imix/stez80/stez80/Design-Review-v0-1.ods

Schematic checks | Result | Comment
Global
Pass ERC | OK | 0 Errors, 0 Warnings
Remainng Warnings checked and OK | OK | none
Testing
LEDs on all power lines | OK
Power management
All power lines clearly labeled | OK
Polarity protection if required | OK
Fuse if necessary | none
Schematic – CPU
Title block filled out correctly | OK
All separate blocks have name/border | OK
All properly aligned | OK
Schematic – Support
Title block filled out correctly | OK
All separate blocks have name/border | OK
All properly aligned | OK
U1 – Schmitt Trigger
Label corresponds to component | OK | 74LS14 but should work
All labeled Inputs connect to correct net | OK
All Power pins have a decoupling cap | OK
All Power pins are connected to the correct voltage rail | OK
All unused pins are correctly NC, pull UP or Down | OK
Pin numbers correspond to function in Datasheet | OK
Footprint form factor matches Datasheet | OK
Footprint pinout matches Datasheet | OK
U2 – Z80 CPU
Label corresponds to component | OK
Adress Bus correctly connected | OK
Data Bus correctly connected | OK
All labeled Inputs connect to correct net | OK
All Power pins have a decoupling cap | OK
All Power pins are connected to the correct voltage rail | OK
All unused pins are correctly NC, pull UP or Down | OK
Pin numbers correspond to function in Datasheet | OK
Footprint form factor matches Datasheet | OK
Footprint pinout matches Datasheet | OK
U3 – RAM
Label corresponds to component | OK
Adress Bus correctly connected | OK
Data Bus correctly connected | OK
All labeled Inputs connect to correct net | OK
All Power pins have a decoupling cap | OK
All Power pins are connected to the correct voltage rail
All unused pins are correctly NC, pull UP or Down | OK
Pin numbers correspond to function in Datasheet | OK
Footprint form factor matches Datasheet
Footprint pinout matches Datasheet
U4 – ROM
Label corresponds to component | OK
Adress Bus correctly connected | OK
Data Bus correctly connected | OK
All labeled Inputs connect to correct net | OK
All Power pins have a decoupling cap | OK
All Power pins are connected to the correct voltage rail | OK
All unused pins are correctly NC, pull UP or Down | OK
Pin numbers correspond to function in Datasheet | OK
Footprint form factor matches Datasheet | OK
Footprint pinout matches Datasheet | OK
U5 Atmega
Label corresponds to component | OK
Adress Bus correctly connected | OK
Data Bus correctly connected | OK
All labeled Inputs connect to correct net | OK
All Power pins have a decoupling cap | OK
All Power pins are connected to the correct voltage rail | OK
All unused pins are correctly NC, pull UP or Down | OK
Pin numbers correspond to function in Datasheet | OK
Footprint form factor matches Datasheet | OK
Footprint pinout matches Datasheet | OK
U6 SIO
Label corresponds to component | OK
Adress Bus correctly connected | OK
Data Bus correctly connected | OK
All labeled Inputs connect to correct net | OK
All Power pins have a decoupling cap | OK
All Power pins are connected to the correct voltage rail | OK
All unused pins are correctly NC, pull UP or Down |  | channel B? Leave as is for the moment
Pin numbers correspond to function in Datasheet | OK
Footprint form factor matches Datasheet | OK
Footprint pinout matches Datasheet | Ok
U7 MAX232
Label corresponds to component | OK
All labeled Inputs connect to correct net |  | 1uF Ceramic or Tantalum
All Power pins have a decoupling cap | OK
All Power pins are connected to the correct voltage rail | OK
All unused pins are correctly NC, pull UP or Down | OK
Pin numbers correspond to function in Datasheet | OK
Footprint form factor matches Datasheet | OK
Footprint pinout matches Datasheet | OK
Y1 Crystal
Resistors
Correct values for application | OK
Correct wattage for application | OK
Footprint form factor as required
Diodes
Correct polarity | OK
Correct wattage for application | OK
LEDs
Correct polarity | OK
Resistor properly calculated | OK
Capacitors
Correct polarity if relevant | OK
Correct Voltage Rating | OK
J1 Debug Port
Pin numbers correspond to function in Datasheet | OK
Footprint form factor matches Datasheet | OK
J2 DC Jack
Pin numbers correspond to function in Datasheet | OK
Footprint form factor matches Datasheet | OK
J3 RS232
Pin numbers correspond to function in Datasheet | OK
Footprint form factor matches Datasheet | OK
PCB checks
Run DRC
Footprints well aligned | good enough…
If sockets are planned, enough space | good enough?
PCB markings, date, version, name etc. | OK
stackup corresponds to factory | not relevant
limits correspond to factory | OK
no sensitive tracks under noisy components
U1 decoupling | OK
U2 decoupling | OK
U3 decouping | OK
U4 decoupling | OK
U5 decoupling | not ideal
U6 decoupling | OK
U7 decoupling | OK
Y1 decoupling | OK
