imix/stez80/stez80/exports/stez80.pdf

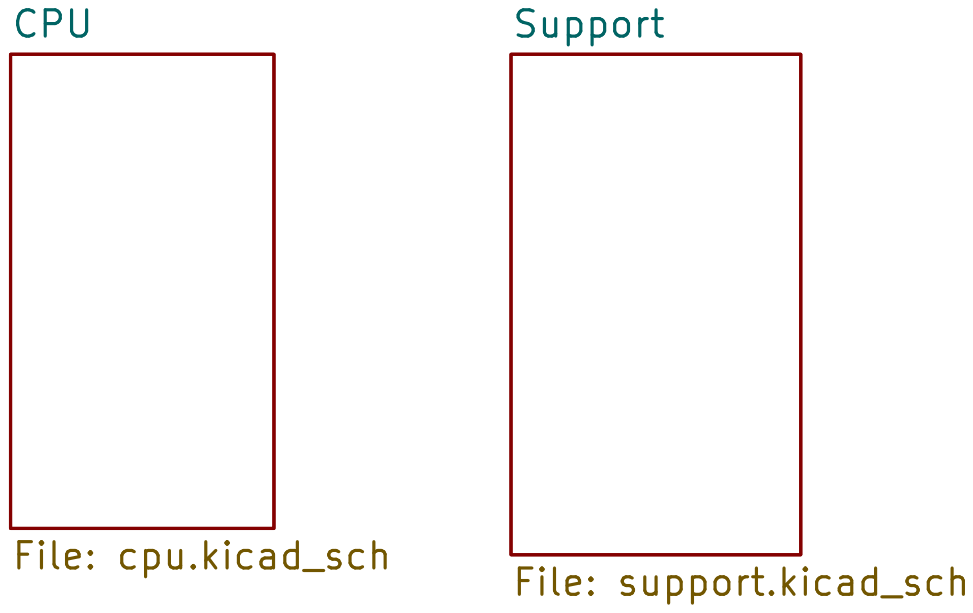
[picture p1: page 1]

Support File: support.kicad_sch CPU

File: stez80.kicad_sch Sheet: /
Id: 1/3 Title: Ste z80 board

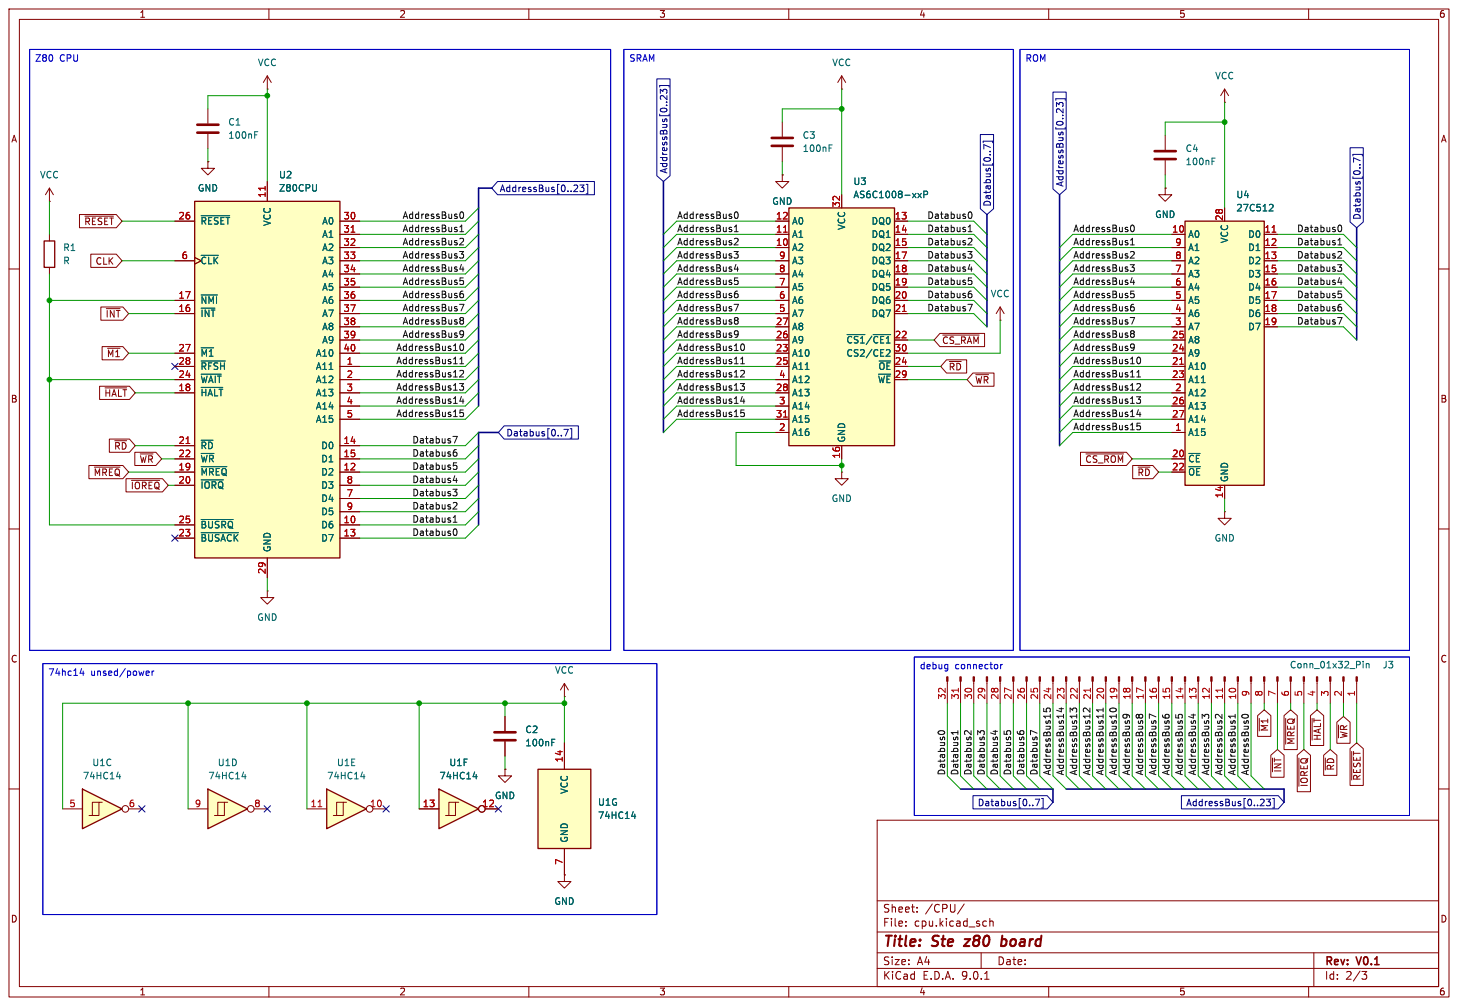
[picture p2: page 2]

File: cpu.kicad_sch Sheet: /CPU/
Id: 2/3 Title: Ste z80 board

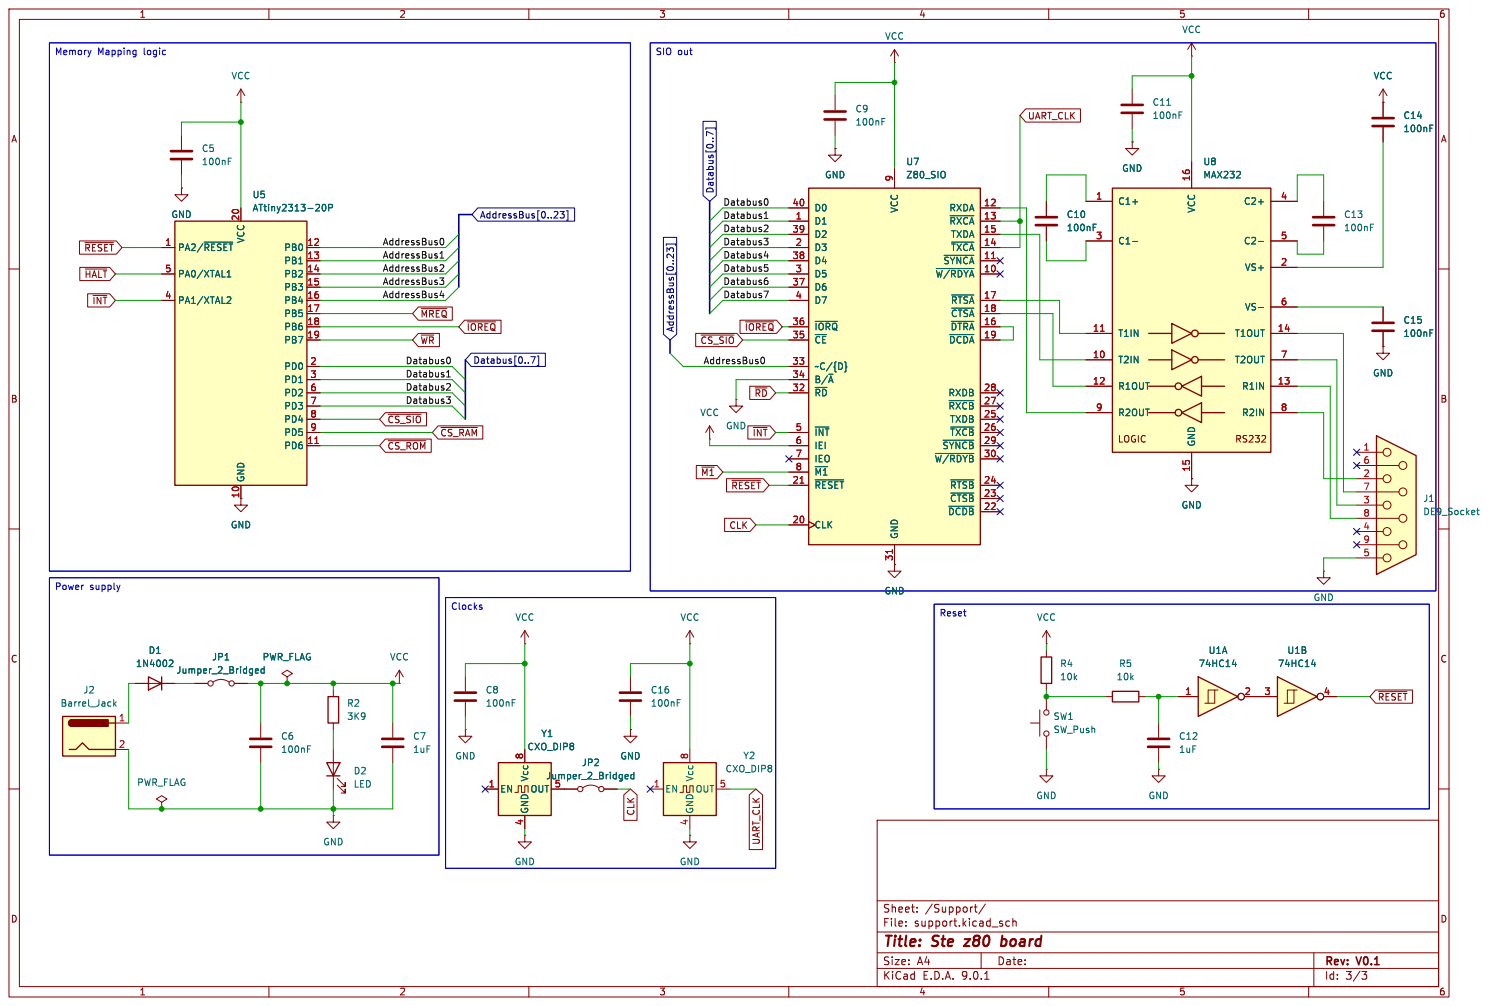
[picture p3: page 3]

9 GND 31 RXDA 12 ~{RXCA}13 TXDA 15 ~{TXCA}14 ~{SYNCA}11 ~{W/RDYA}10 ~{RTSA}17 ~{CTSA}18 ~{DTRA}16 ~{DCDA}19 RXDB 28 ~{RXCB}27 TXDB 25 ~{TXCB}26 ~{SYNCB}29 ~{W/RDYB}30 ~{RTSB}24 ~{CTSB}23 ~{DCDB}22 U7 Z80_SIO

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

File: support.kicad_sch Sheet: /Support/
Id: 3/3 Title: Ste z80 board
