imix/stez80/stez80/stez80.kicad_pcb

## KiCad design stez80/stez80.kicad_pcb (2025-05-18)

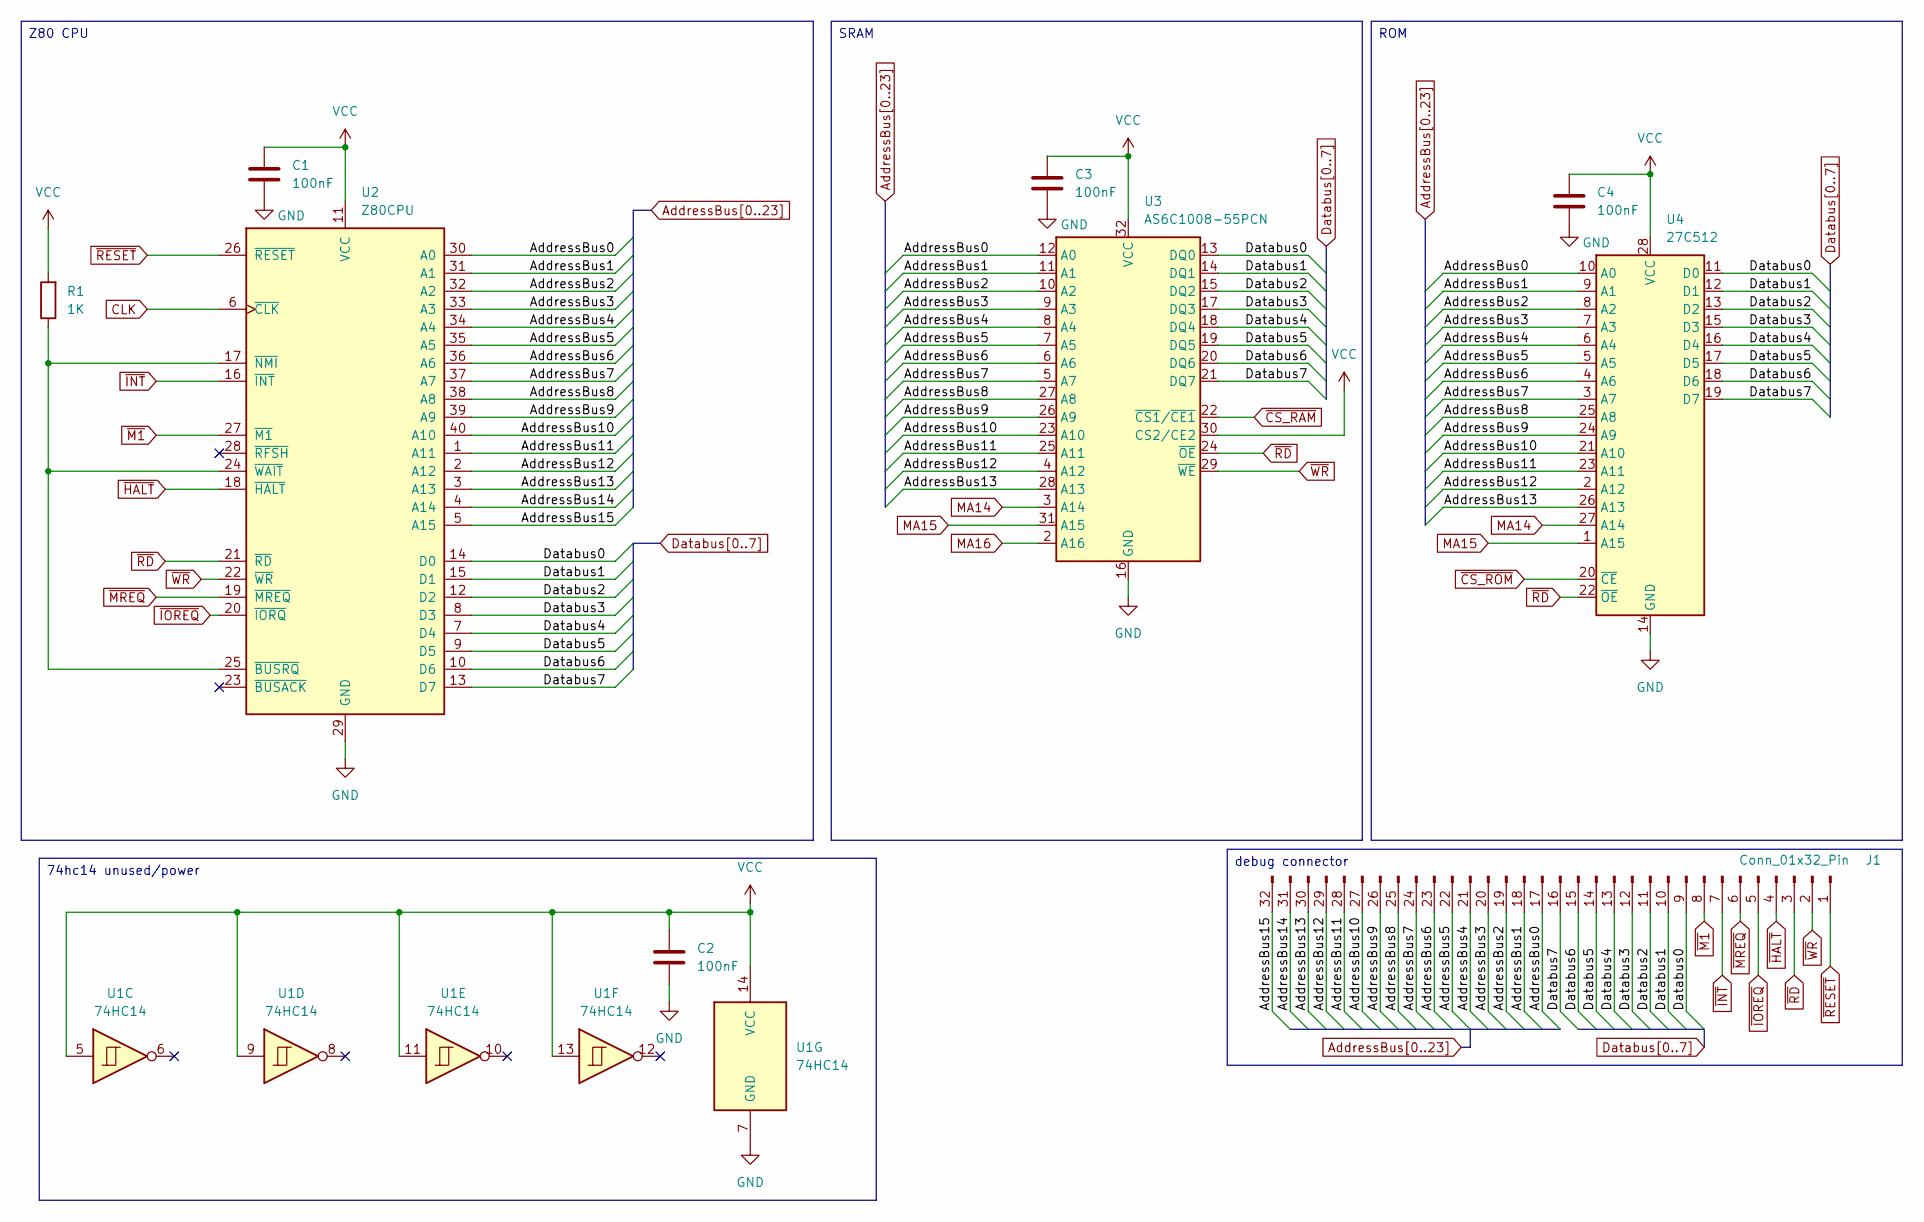
[picture p4: schematic cpu.kicad_sch, Ste z80 board]

Parts:
C1, C2, C3, C4: 100nF; C_Rect_L7.0mm_W2.0mm_P5.00mm
J1: Conn_01x32_Pin; PinHeader_1x32_P2.54mm_Vertical
R1: 1K; R_Axial_DIN0207_L6.3mm_D2.5mm_P2.54mm_Vertical
U1: 74HC14; DIP-14_W7.62mm
U2: Z80CPU; DIP-40_W15.24mm_LongPads
U3: AS6C1008-55PCN; DIP-32_W15.24mm_LongPads
U4: 27C512; DIP-28_W15.24mm_LongPads

Connections:
AddressBus0: J1.17, U2.30 (A0), U3.12 (A0), U4.10 (A0); also elsewhere on the board
AddressBus1: J1.18, U2.31 (A1), U3.11 (A1), U4.9 (A1); also elsewhere on the board
AddressBus2: J1.19, U2.32 (A2), U3.10 (A2), U4.8 (A2); also elsewhere on the board
AddressBus3: J1.20, U2.33 (A3), U3.9 (A3), U4.7 (A3); also elsewhere on the board
AddressBus4: J1.21, U2.34 (A4), U3.8 (A4), U4.6 (A4); also elsewhere on the board
AddressBus5: J1.22, U2.35 (A5), U3.7 (A5), U4.5 (A5); also elsewhere on the board
AddressBus6: J1.23, U2.36 (A6), U3.6 (A6), U4.4 (A6); also elsewhere on the board
AddressBus7: J1.24, U2.37 (A7), U3.5 (A7), U4.3 (A7); also elsewhere on the board
AddressBus8: J1.25, U2.38 (A8), U3.27 (A8), U4.25 (A8)
AddressBus9: J1.26, U2.39 (A9), U3.26 (A9), U4.24 (A9)
AddressBus10: J1.27, U2.40 (A10), U3.23 (A10), U4.21 (A10)
AddressBus11: J1.28, U2.1 (A11), U3.25 (A11), U4.23 (A11)
AddressBus12: J1.29, U2.2 (A12), U3.4 (A12), U4.2 (A12)
AddressBus13: J1.30, U2.3 (A13), U3.28 (A13), U4.26 (A13)
AddressBus14: J1.31, U2.4 (A14); also elsewhere on the board
AddressBus15: J1.32, U2.5 (A15); also elsewhere on the board
CLK: U2.6 (~CLK); also elsewhere on the board
Databus0: J1.9, U2.14 (D0), U3.13 (DQ0), U4.11 (D0); also elsewhere on the board
Databus1: J1.10, U2.15 (D1), U3.14 (DQ1), U4.12 (D1); also elsewhere on the board
Databus2: J1.11, U2.12 (D2), U3.15 (DQ2), U4.13 (D2); also elsewhere on the board
Databus3: J1.12, U2.8 (D3), U3.17 (DQ3), U4.15 (D3); also elsewhere on the board
Databus4: J1.13, U2.7 (D4), U3.18 (DQ4), U4.16 (D4); also elsewhere on the board
Databus5: J1.14, U2.9 (D5), U3.19 (DQ5), U4.17 (D5); also elsewhere on the board
Databus6: J1.15, U2.10 (D6), U3.20 (DQ6), U4.18 (D6); also elsewhere on the board
Databus7: J1.16, U2.13 (D7), U3.21 (DQ7), U4.19 (D7); also elsewhere on the board
GND: C1.2, C2.2, C3.2, C4.2, U1.7 (GND), U2.29 (GND), U3.16 (GND), U4.14 (GND); also elsewhere on the board
MA14: U3.3 (A14), U4.27 (A14); also elsewhere on the board
MA15: U3.31 (A15), U4.1 (A15); also elsewhere on the board
MA16: U3.2 (A16); also elsewhere on the board
unnamed: R1.1, U2.17 (~NMI), U2.24 (~WAIT), U2.25 (~BUSRQ)
VCC: C1.1, C2.1, C3.1, C4.1, R1.2, U1.5, U1.9, U1.11, U1.13, U1.14 (VCC), U2.11 (VCC), U3.30 (CS2/CE2), U3.32 (VCC), U4.28 (VCC); also elsewhere on the board
~CS_RAM: U3.22 (~CS1/~CE1); also elsewhere on the board
~CS_ROM: U4.20 (~CE); also elsewhere on the board
~HALT: J1.4, U2.18 (~HALT); also elsewhere on the board
~INT: J1.7, U2.16 (~INT); also elsewhere on the board
~IOREQ: J1.5, U2.20 (~IORQ); also elsewhere on the board
~M1: J1.8, U2.27 (~M1); also elsewhere on the board
~MREQ: J1.6, U2.19 (~MREQ); also elsewhere on the board
~RD: J1.3, U2.21 (~RD), U3.24 (~OE), U4.22 (~OE); also elsewhere on the board
~RESET: J1.1, U2.26 (~RESET); also elsewhere on the board
~WR: J1.2, U2.22 (~WR), U3.29 (~WE); also elsewhere on the board

Notes on the sheet:
74hc14 unused/power
ROM
SRAM
Z80 CPU
debug connector

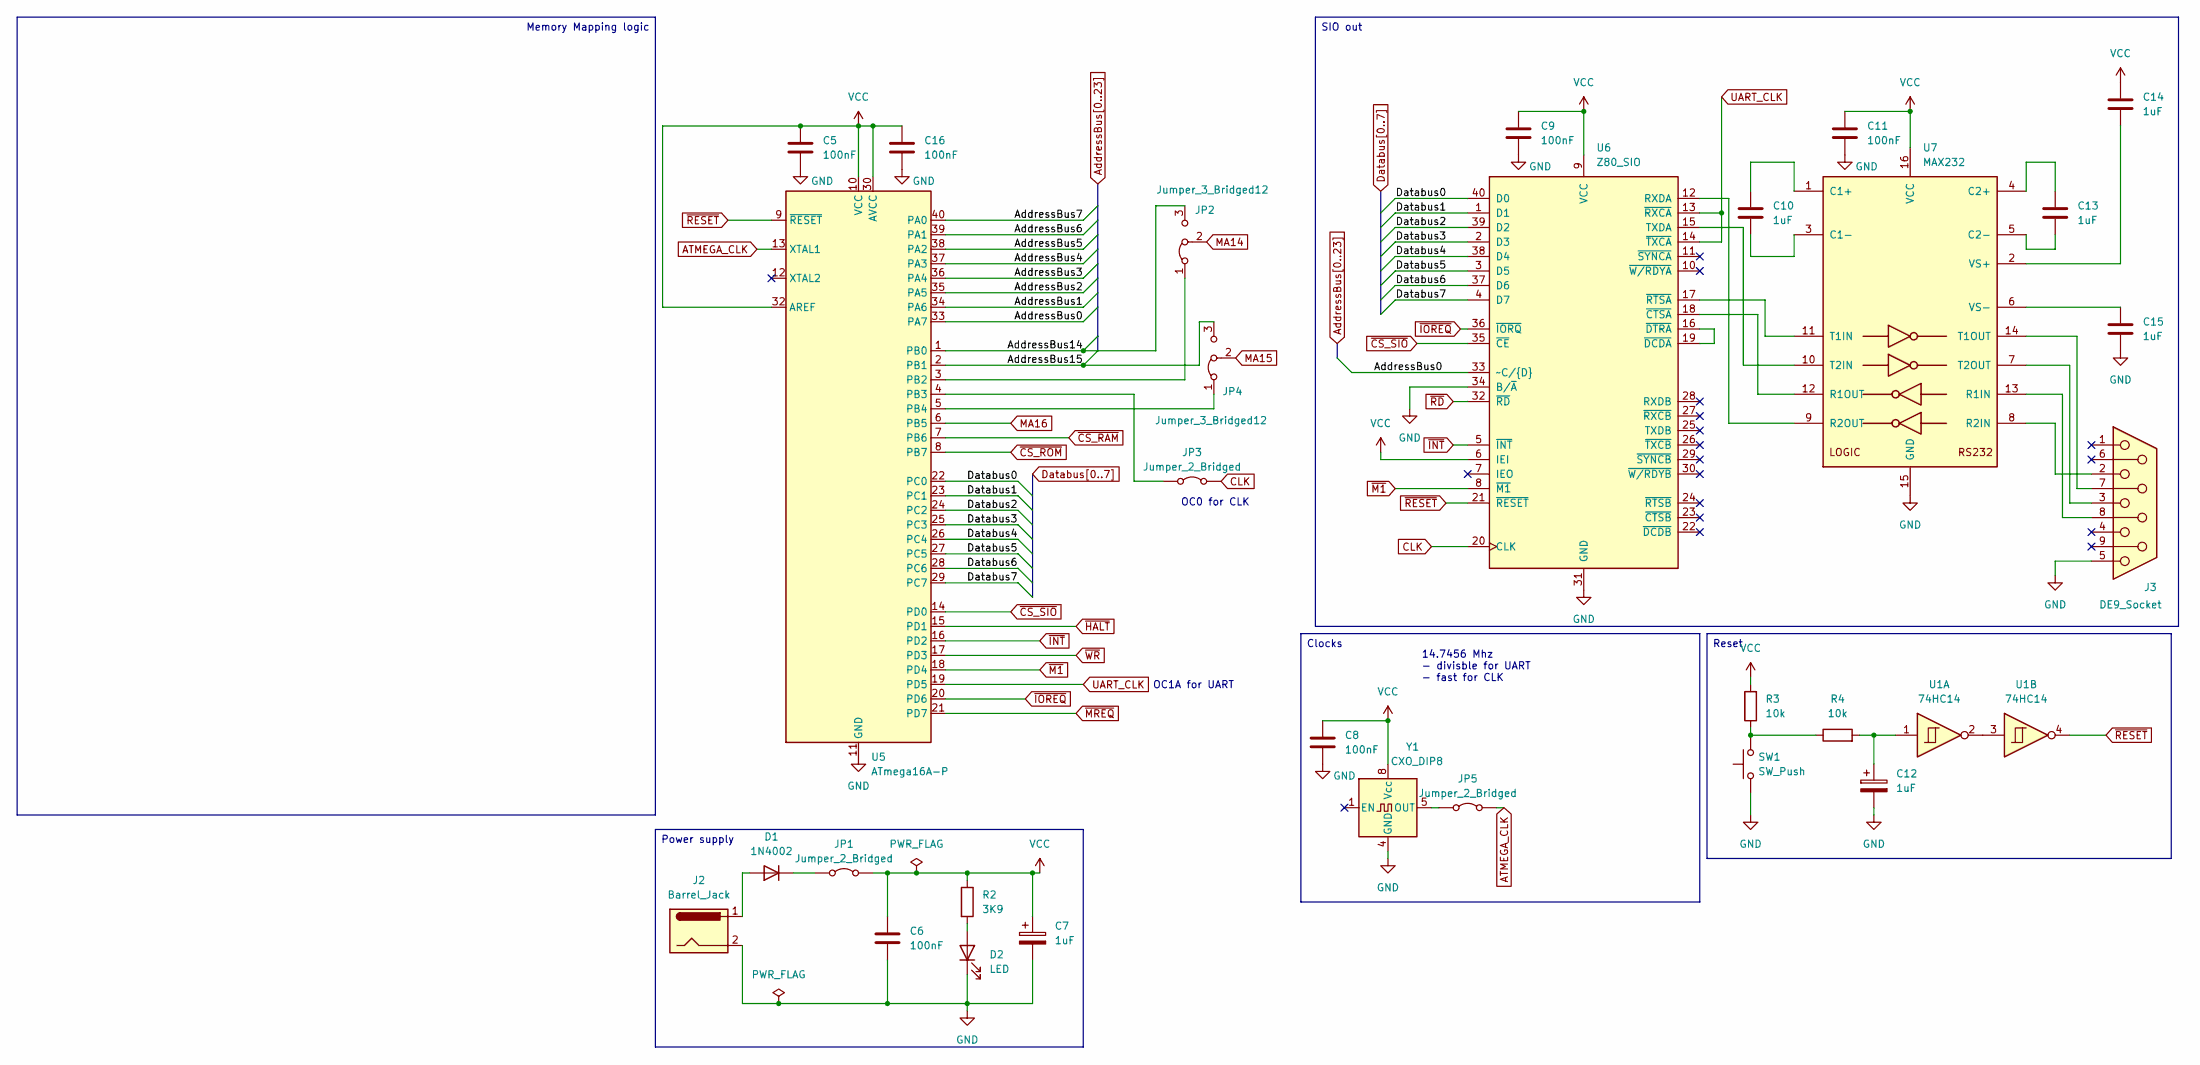
[picture p5: schematic support.kicad_sch, Ste z80 board]

Parts:
C5, C6, C8, C9, C11, C16: 100nF; C_Rect_L7.0mm_W2.0mm_P5.00mm
C7, C12: 1uF; CP_Radial_D5.0mm_P2.50mm
C10, C13, C14, C15: 1uF; C_Rect_L7.0mm_W2.0mm_P5.00mm
D1: 1N4002; D_DO-15_P15.24mm_Horizontal
D2: LED; LED_D3.0mm_Clear
J2: Barrel_Jack; BarrelJack_GCT_DCJ200-10-A_Horizontal
J3: DE9_Socket; DSUB-9_Socket_Horizontal_P2.77x2.84mm_EdgePinOffset7.70mm_H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
JP1, JP3, JP5: Jumper_2_Bridged; PinHeader_1x02_P2.54mm_Vertical
JP2, JP4: Jumper_3_Bridged12; PinHeader_1x03_P2.54mm_Vertical
R2: 3K9; R_Axial_DIN0207_L6.3mm_D2.5mm_P2.54mm_Vertical
R3, R4: 10k; R_Axial_DIN0207_L6.3mm_D2.5mm_P2.54mm_Vertical
SW1: SW_Push; SW_PUSH_6mm_H7.3mm
U1: 74HC14; DIP-14_W7.62mm
U5: ATmega16A-P; DIP-40_W15.24mm_LongPads
U6: Z80_SIO; DIP-40_W15.24mm_LongPads
U7: MAX232; DIP-16_W7.62mm_LongPads
Y1: CXO_DIP8; Oscillator_DIP-8

Connections:
ATMEGA_CLK: JP5.2 (B), U5.13 (XTAL1)
AddressBus0: U5.33 (PA7), U6.33 (~C/{D}); also elsewhere on the board
AddressBus1: U5.34 (PA6); also elsewhere on the board
AddressBus2: U5.35 (PA5); also elsewhere on the board
AddressBus3: U5.36 (PA4); also elsewhere on the board
AddressBus4: U5.37 (PA3); also elsewhere on the board
AddressBus5: U5.38 (PA2); also elsewhere on the board
AddressBus6: U5.39 (PA1); also elsewhere on the board
AddressBus7: U5.40 (PA0); also elsewhere on the board
AddressBus14: JP2.3 (B), U5.1 (PB0); also elsewhere on the board
AddressBus15: JP4.3 (B), U5.2 (PB1); also elsewhere on the board
CLK: JP3.2 (B), U6.20 (CLK); also elsewhere on the board
Databus0: U5.22 (PC0), U6.40 (D0); also elsewhere on the board
Databus1: U5.23 (PC1), U6.1 (D1); also elsewhere on the board
Databus2: U5.24 (PC2), U6.39 (D2); also elsewhere on the board
Databus3: U5.25 (PC3), U6.2 (D3); also elsewhere on the board
Databus4: U5.26 (PC4), U6.38 (D4); also elsewhere on the board
Databus5: U5.27 (PC5), U6.3 (D5); also elsewhere on the board
Databus6: U5.28 (PC6), U6.37 (D6); also elsewhere on the board
Databus7: U5.29 (PC7), U6.4 (D7); also elsewhere on the board
GND: C5.2, C6.2, C7.2, C8.2, C9.2, C11.2, C12.2, C15.2, C16.2, D2.1 (K), J2.2, J3.5, SW1.1, U5.11 (GND), U5.31 (GND), U6.31 (GND), U6.34 (B/~A), U7.15 (GND), Y1.4 (GND); also elsewhere on the board
MA14: JP2.2 (C); also elsewhere on the board
MA15: JP4.2 (C); also elsewhere on the board
MA16: U5.6 (PB5); also elsewhere on the board
unnamed: C12.1, R4.2, U1.1
unnamed: D1.2 (A), J2.1
unnamed: D1.1 (K), JP1.1 (A)
unnamed: D2.2 (A), R2.2
unnamed: JP2.1 (A), U5.3 (PB2)
unnamed: JP3.1 (A), U5.4 (PB3)
unnamed: JP4.1 (A), U5.5 (PB4)
unnamed: JP5.1 (A), Y1.5 (OUT)
unnamed: R3.1, R4.1, SW1.2
unnamed: U1.2, U1.3
unnamed: U6.12 (RXDA), U7.9 (R2OUT)
unnamed: U6.15 (TXDA), U7.10 (T2IN)
unnamed: U6.18 (~CTSA), U7.12 (R1OUT)
unnamed: U6.16 (~DTRA), U6.19 (~DCDA)
unnamed: U6.17 (~RTSA), U7.11 (T1IN)
unnamed: C10.1, U7.1 (C1+)
unnamed: C10.2, U7.3 (C1-)
unnamed: C13.1, U7.4 (C2+)
unnamed: C13.2, U7.5 (C2-)
unnamed: J3.8, U7.13 (R1IN)
unnamed: J3.2, U7.8 (R2IN)
unnamed: J3.7, U7.14 (T1OUT)
unnamed: J3.3, U7.7 (T2OUT)
unnamed: C14.2, U7.2 (VS+)
unnamed: C15.1, U7.6 (VS-)
UART_CLK: U5.19 (PD5), U6.13 (~RXCA), U6.14 (~TXCA)
VCC: C5.1, C6.1, C7.1, C8.1, C9.1, C11.1, C14.1, C16.1, JP1.2 (B), R2.1, R3.2, U5.10 (VCC), U5.30 (AVCC), U5.32 (AREF), U6.6 (IEI), U6.9 (VCC), U7.16 (VCC), Y1.8 (Vcc); also elsewhere on the board
~CS_RAM: U5.7 (PB6); also elsewhere on the board
~CS_ROM: U5.8 (PB7); also elsewhere on the board
~CS_SIO: U5.14 (PD0), U6.35 (~CE)
~HALT: U5.15 (PD1); also elsewhere on the board
~INT: U5.16 (PD2), U6.5 (~INT); also elsewhere on the board
~IOREQ: U5.20 (PD6), U6.36 (~IORQ); also elsewhere on the board
~M1: U5.18 (PD4), U6.8 (~M1); also elsewhere on the board
~MREQ: U5.21 (PD7); also elsewhere on the board
~RD: U6.32 (~RD); also elsewhere on the board
~RESET: U1.4, U5.9 (~RESET), U6.21 (~RESET); also elsewhere on the board
~WR: U5.17 (PD3); also elsewhere on the board

Notes on the sheet:
OC0 for CLK
14.7456 Mhz - divisble for UART - fast for CLK
OC1A for UART
SIO out
Power supply
Reset
Memory Mapping logic
Clocks

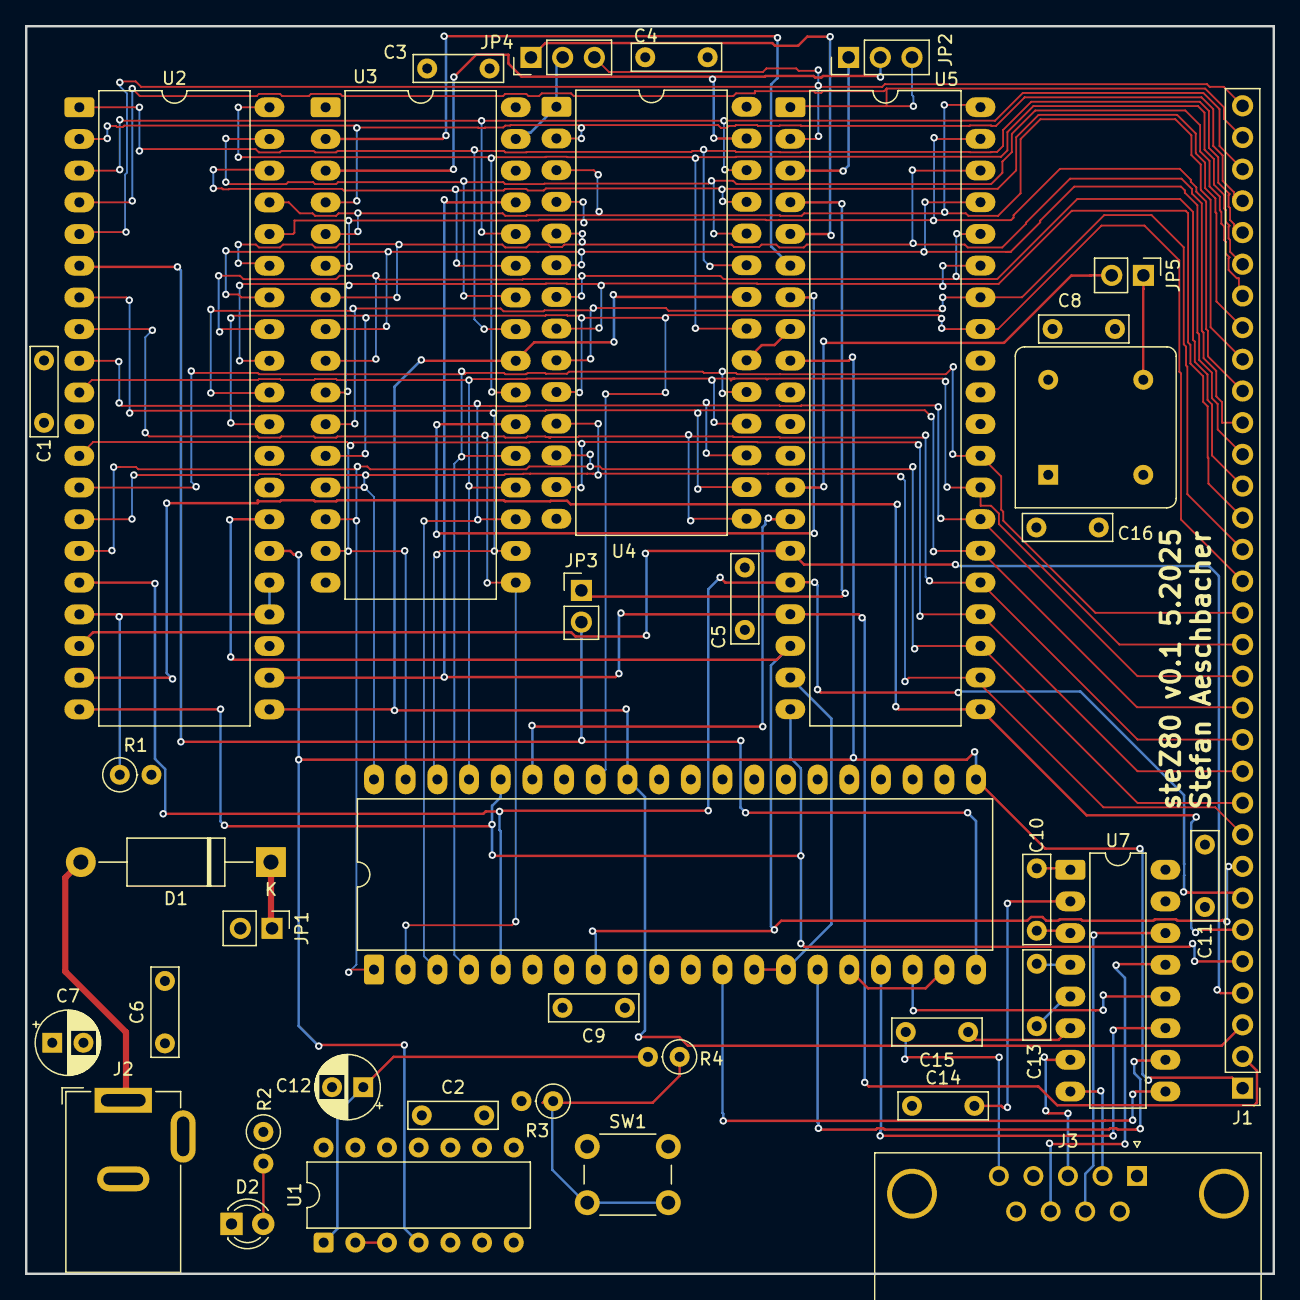
[picture p6: board stez80.kicad_pcb from above]

Board: 4 copper layers, 100.0 x 100.0 mm, 39 parts (0 on the bottom side), 69 nets.
