imix/stez80/(commit log)

2025-04-27 initial import schematics
    [cpu.kicad_sch, memory.kicad_sch, stez80.kicad_pcb, stez80.kicad_sch, support.kicad_sch]
2025-05-10 pcb layout
    [cpu.kicad_sch, stez80.kicad_pcb, support.kicad_sch]
2025-05-13 review wip
    [cpu.kicad_sch, stez80.kicad_pcb, support.kicad_sch]
2025-05-17 continue review
    [Design-Review-v0-1.ods, cpu.kicad_sch, stez80.kicad_pcb, support.kicad_sch]
